justinb4003/mutebutton-circuitpy/cad/mutebutton_base_p1s_petg.gcode.3mf

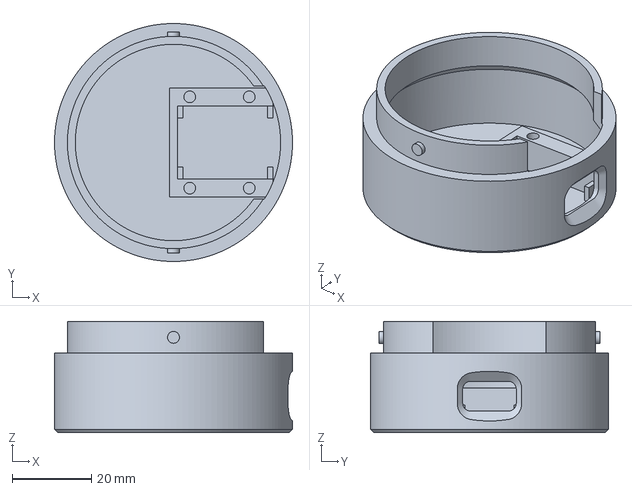
[picture p1: CAD file, 2026-11-09]
cad/mutebutton_base_p1s_petg.gcode.3mf
60.0 x 60.0 x 28.0 mm
