justinb4003/mutebutton-circuitpy/cad/stl/mutebutton_plate.stl

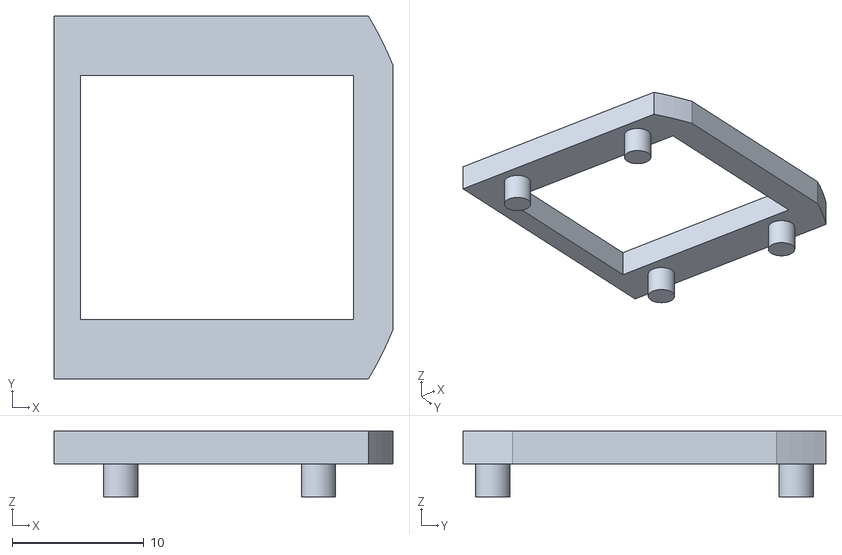
[picture p2: CAD file, 2026-11-09]
cad/stl/mutebutton_plate.stl
25.7 x 27.5 x 5.00
