justinb4003/mutebutton-circuitpy/cad/mutebutton_p1s_petg.gcode.3mf

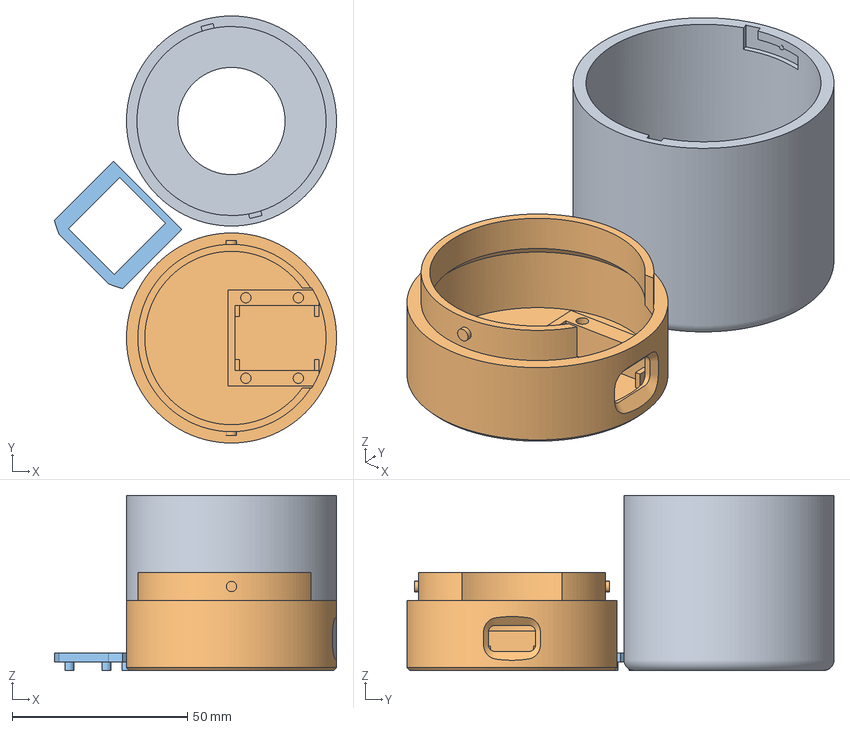
[picture p3: CAD file, 2026-11-09]
cad/mutebutton_p1s_petg.gcode.3mf
80.6 x 122.0 x 50.0 mm
mutebutton_top.stl
mutebutton_base.stl
mutebutton_plate.stl
