justinb4003/mutebutton-circuitpy/cad/stl/mutebutton_top.stl

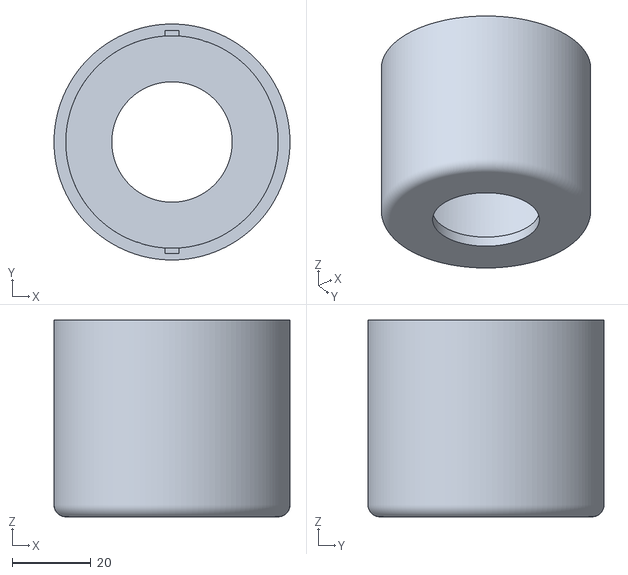
[picture p4: CAD file, 2026-11-09]
cad/stl/mutebutton_top.stl
60.0 x 60.0 x 50.0
