justinb4003/mutebutton-circuitpy/(list of files, cad)

Other CAD files:
cad/stl/mutebutton_base.stl
