justinb4003/mutebutton-circuitpy/(commit log)

2025-07-05 Add diagram for button wiring
2025-07-06 Added pic of wired up system
2025-07-07 Fixed circuitpy version
2026-09-23 Add short/long press actions and Waveshare RP2040-Zero support
    The button now does two things depending on how long it is held:
    * Short click sends Ctrl+Shift+K, the Teams raise-hand shortcut.
    * Holding for LONG_PRESS_SECONDS (0.4s) sends Win+Alt+K, the Windows
    level mute toggle. That fires the moment the threshold is crossed so
    there is immediate feedback, and releasing the button afterwards
    deliberately does nothing.
    Also adds a short debounce on press and release, and polls at 10ms while
    the button is held so the threshold lands near the real 0.4s rather than
    snapping to a coarse tick.
    main.py is now portable across both boards we use. It picks the button
    pin by probing for D7 (X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
    [main.py]
2026-11-09 Add 3D-printable enclosure for the RP2040-Zero mute button
    Parametric FreeCAD script (cad/enclosure.py) for a hand-held 60mm
    cylinder: a 30mm screw-in arcade button in the top, the RP2040-Zero in
    a cradle at the bottom with a retainer plate, and a chamfered USB-C
    opening in the side. The top shell twist-locks onto the base with a
    two-pin bayonet. The base's spigot is notched so the board and plate
    drop straight into the cradle.
    Includes the exported STLs and Bambu Studio slices for a P1S with a
    0.6mm nozzle in PETG.
